antonio-paulino/AccessControlSystem/Hardware/testbenches/KeyBoardReader/KeyDecode/Adder2_tb_100ns.vhd

LIBRARY ieee;
USE ieee.std_logic_1164.all;

ENTITY Adder2_tb is
end Adder2_tb;

architecture teste of Adder2_tb is
	component Adder2 is
	PORT( 
			A 		: in std_logic_vector(1 downto 0);
			B 		: in std_logic_vector(1 downto 0);
			CI 	: in std_logic;
			S 		: out std_logic_vector(1 downto 0);
			CO 	: out std_logic
		);	
	end component;

	constant MCLK_PERIOD: time:= 20 ns;
	constant MCLK_HALF_PERIOD: time := MCLK_PERIOD/2;


	signal CI_tb, CO_tb: std_logic; 
	signal A_tb, B_tb, S_tb : std_logic_vector(1 downto 0);



	Begin 
		UUT: Adder2 
			port map ( 
					A  => A_tb,
					B  => B_tb,
					CI => CI_tb,
					S  => S_tb,
					CO => CO_tb
				);

		stimulus: process
		begin
			A_tb 	<= "00";
			B_tb 	<= "00";
			CI_tb <= '1';
			wait for MCLK_PERIOD;
			A_tb 	<= "10";
			B_tb 	<= "01";
			CI_tb <= '1';
			wait for MCLK_PERIOD;
			A_tb 	<= "11";
			B_tb 	<= "01";
			CI_tb	<= '0';
			wait for MCLK_PERIOD;
			A_tb	<= "10";
			B_tb 	<= "00";
			CI_tb <= '0';
			wait for MCLK_PERIOD;
			wait;
			
		end process;
			
end teste;
